VimuthWickramasinghe/robotikka/Schematic.pdf

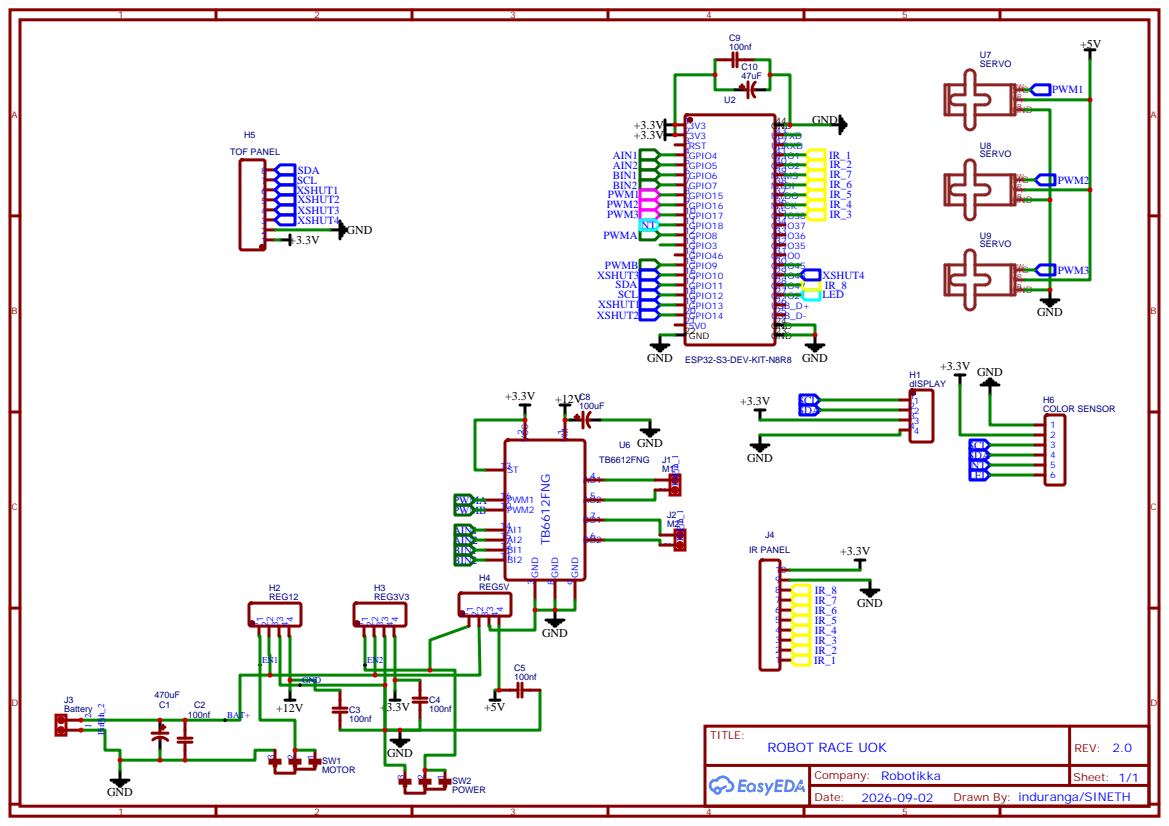
[picture p1: page 1]

Drawn By: induranga/SINETH
