VimuthWickramasinghe/robotikka/LineSensor.cpp

#include "LineSensor.h"
#include "MotorDriver.h"
#include "IRDisplay.h"
#include "globals.h"

// ==============================================================================
// GLOBAL PID VARIABLES
// ==============================================================================

// Global PID configuration (tuned defaults)
PIDConfig g_pidConfig = {
  45.0f,   // Kp
  0.0f,    // Ki
  25.0f,   // Kd
  50,     // baseSpeed (0 - 255)
  50,     // maxSpeed (0 - 255)
  -100,    // minSpeed (-255 to 255, allows reverse pivot on sharp curves)
  50.0f,   // maxIntegral (anti-windup clamp)
  2000     // threshold (12-bit ADC threshold: 0 - 4095)
};

PIDConfig &pidConfig = g_pidConfig;

// Dedicated PID configuration for dashed / dotted lines
// Uses gentle Kp/Kd and a controlled base speed to avoid abrupt turning during gap entries/exits
PIDConfig g_dashPidConfig = {
  35.0f,   // Kp: lower proportional gain for smoother gap transitions
  0.0f,    // Ki: zero integral to prevent windup during line loss
  20.0f,   // Kd: damping
  45,      // baseSpeed: moderate speed for stable dash tracking
  50,      // maxSpeed
  0,       // minSpeed: keep wheels moving forward (no aggressive pivot in dashes)
  30.0f,   // maxIntegral
  2000     // threshold (fallback threshold)
};

// Global runtime tracking variables
float g_lineLastError = 0.0f;
float g_lineIntegral = 0.0f;
LineSensorState g_lastLineState = {};

// Internal static tracking variables
static float s_lastValidPosition = 0.0f;
static unsigned long s_lineLostTime = 0;
static unsigned long s_lastMicros = 0;

// ==============================================================================
// FUNCTIONS
// ==============================================================================

void resetLinePID() {
  g_lineLastError = 0.0f;
  g_lineIntegral = 0.0f;
  s_lastValidPosition = 0.0f;
  s_lineLostTime = 0;
  s_lastMicros = 0;
}

void initLineSensors() {
  // The line-following PID reads only GPIO2 through GPIO6.
  analogReadResolution(12);
  for (int i = 0; i < LINE_SENSOR_COUNT; i++) {
    pinMode(IR_PINS[i], INPUT);
  }
  resetLinePID();
}

void calibrateLineSensors() {
  if (hTaskCalibration != NULL) {
    g_runMode = IR_CALIBRATE;
    vTaskResume(hTaskCalibration);
  }
}

LineSensorState readLineSensors() {
  LineSensorState state;
  state.activeCount = 0;
  float weightedSum = 0.0f;
  float totalWeight = 0.0f;

  // Sensor array weights from left to right, GPIO2 through GPIO6.
  const float weights[LINE_SENSOR_COUNT] = {-2.0f, -1.0f, 0.0f, 1.0f, 2.0f};

  for (int i = 0; i < LINE_SENSOR_COUNT; i++) {
    state.raw[i] = analogRead(IR_PINS[i]);
    uint16_t thresh = (g_sensorThresholds[i] > 0) ? g_sensorThresholds[i] : g_pidConfig.threshold;
    state.isBlack[i] = (state.raw[i] > thresh);
    if (state.isBlack[i]) {
      state.activeCount++;
      weightedSum += weights[i];
      totalWeight += 1.0f;
    }
  }

  if (state.activeCount > 0) {
    state.lineFound = true;
    state.isDottedGap = false;
    state.position = weightedSum / totalWeight;
    s_lastValidPosition = state.position;
    s_lineLostTime = 0;
  } else {
    // No sensor currently detects the line
    state.lineFound = false;
    if (s_lineLostTime == 0) {
      s_lineLostTime = millis();
    }

    // Trajectory hold across dotted gaps (< 350 ms)
    if (millis() - s_lineLostTime < 350) {
      state.isDottedGap = true;
      state.position = s_lastValidPosition;
    } else {
      state.isDottedGap = false;
      // Hard off-track: maintain sign of last seen position to steer back towards line
      state.position = (s_lastValidPosition >= 0.0f) ? 2.0f : -2.0f;
    }
  }

  g_lastLineState = state;
  return state;
}

void follow_line() {
  LineSensorState state = readLineSensors();
  queueIRDisplayUpdate(state, false);

  unsigned long nowMicros = micros();
  float dt = (s_lastMicros == 0) ? 0.002f : (float)(nowMicros - s_lastMicros) / 1000000.0f;
  if (dt <= 0.0f || dt > 0.05f) {
    dt = 0.002f; // Fallback to nominal 2 ms (500 Hz) if jitter or first call
  }
  s_lastMicros = nowMicros;

  float lineError = state.position;

  // Proportional term
  float P = g_pidConfig.Kp * lineError;

  // Integral term with anti-windup clamp
  g_lineIntegral += (lineError * dt);
  g_lineIntegral = constrain(g_lineIntegral, -g_pidConfig.maxIntegral, g_pidConfig.maxIntegral);
  float I = g_pidConfig.Ki * g_lineIntegral;

  // Derivative term (rate of change of error)
  float D = g_pidConfig.Kd * ((lineError - g_lineLastError) / dt);
  g_lineLastError = lineError;

  // Total steering correction
  float correction = P + I + D;

  // Differential drive motor speeds:
  // Motor A = Left Motor, Motor B = Right Motor
  // If lineError > 0 (line is to the right): Left speeds up, Right slows down -> turns Right
  int leftMotorSpeed  = g_pidConfig.baseSpeed + (int)correction;
  int rightMotorSpeed = g_pidConfig.baseSpeed - (int)correction;

  // If currently traversing a dotted gap, maintain straight forward momentum
  if (state.isDottedGap) {
    leftMotorSpeed  = g_pidConfig.baseSpeed;
    rightMotorSpeed = g_pidConfig.baseSpeed;
  }

  // Constrain outputs to configured limits
  leftMotorSpeed  = constrain(leftMotorSpeed, g_pidConfig.minSpeed, g_pidConfig.maxSpeed);
  rightMotorSpeed = constrain(rightMotorSpeed, g_pidConfig.minSpeed, g_pidConfig.maxSpeed);

  setMotorASpeed(rightMotorSpeed);
  setMotorBSpeed(leftMotorSpeed);
}

void follow_dash_line() {
  LineSensorState state = readLineSensors();
  queueIRDisplayUpdate(state, false);

  unsigned long nowMicros = micros();
  float dt = (s_lastMicros == 0) ? 0.002f : (float)(nowMicros - s_lastMicros) / 1000000.0f;
  if (dt <= 0.0f || dt > 0.05f) {
    dt = 0.002f; // Fallback to nominal 2 ms (500 Hz)
  }
  s_lastMicros = nowMicros;

  float lineError = state.position;

  // When sensors see the dash segment, apply dash PID steering
  if (state.lineFound) {
    float P = g_dashPidConfig.Kp * lineError;

    // Integral term with anti-windup clamp
    g_lineIntegral += (lineError * dt);
    g_lineIntegral = constrain(g_lineIntegral, -g_dashPidConfig.maxIntegral, g_dashPidConfig.maxIntegral);
    float I = g_dashPidConfig.Ki * g_lineIntegral;

    // Derivative term
    float D = g_dashPidConfig.Kd * ((lineError - g_lineLastError) / dt);
    g_lineLastError = lineError;

    float correction = P + I + D;

    int leftMotorSpeed  = g_dashPidConfig.baseSpeed + (int)correction;
    int rightMotorSpeed = g_dashPidConfig.baseSpeed - (int)correction;

    leftMotorSpeed  = constrain(leftMotorSpeed, g_dashPidConfig.minSpeed, g_dashPidConfig.maxSpeed);
    rightMotorSpeed = constrain(rightMotorSpeed, g_dashPidConfig.minSpeed, g_dashPidConfig.maxSpeed);

    setMotorASpeed(rightMotorSpeed);
    setMotorBSpeed(leftMotorSpeed);
  } else {
    // Over a gap between dashes:
    // Freeze integral to prevent error accumulation across gaps
    g_lineLastError = 0.0f;

    if (state.isDottedGap) {
      // Hold forward trajectory smoothly through the gap without oscillating
      setMotorASpeed(g_dashPidConfig.baseSpeed);
      setMotorBSpeed(g_dashPidConfig.baseSpeed);
    } else {
      // Line lost longer than dotted gap threshold: slow pivot towards last seen direction
      int pivotSpeed = g_dashPidConfig.baseSpeed / 2;
      if (s_lastValidPosition >= 0.0f) {
        // Line was on the right: turn right
        setMotorASpeed(-pivotSpeed);
        setMotorBSpeed(pivotSpeed);
      } else {
        // Line was on the left: turn left
        setMotorASpeed(pivotSpeed);
        setMotorBSpeed(-pivotSpeed);
      }
    }
  }
}

void printLineSensorValues() {
  LineSensorState state = readLineSensors();
  for (int i = 0; i < LINE_SENSOR_COUNT; i++) {
    Serial.print(state.raw[i]);
    if (i < LINE_SENSOR_COUNT - 1) {
      Serial.print(" ");
    }
  }
  Serial.printf(" | Pos: %+.2f | Count: %d | Found: %s\n",
                state.position, state.activeCount, state.lineFound ? "YES" : "NO");
}
