VimuthWickramasinghe/robotikka/button_task.cpp

#include "globals.h"
#include "Config.h"
#include <Arduino.h>
#include <WiFi.h>

// Task handle references for control
extern TaskHandle_t hTaskTelemetryOTA;
extern TaskHandle_t hTaskRobotControl;
extern TaskHandle_t hTaskCalibration;

// ============================================================
// BUTTON TASK — 8-Color Command Selector
// ============================================================
//
// How it works:
//   1. On boot, buttonTaskInit() attaches an ISR to the BOOT
//      button (GPIO 0) and creates the task in SUSPENDED state.
//   2. When the user presses the BOOT button at any time (even
//      during maze run), the ISR resumes the task.
//   3. The task cycles through 8 colors on the onboard RGB LED.
//      Each color = one command.
//   4. User presses button during the desired color → LED blinks
//      that color for ~3 seconds.
//   5. User presses button again within 3 s → command confirmed,
//      corresponding flag is set, task suspends itself.
//   6. If no press within 3 s → selection cancelled, resumes
//      cycling through all 8 colors.
//
// ============================================================

// --- State Machine ---
enum ButtonState : uint8_t {
    BTN_IDLE,
    BTN_COLOR_SELECT,
    BTN_CONFIRM_BLINK
};

// --- 8 Colors (R, G, B) ---
#define NUM_COLORS 8

struct Color {
    uint8_t r, g, b;
    const char *name;
};

static const Color COLORS[NUM_COLORS] = {
    {255,   0,   0, "linefollow"},
    {  0, 255,   0, "OTA mode"},
    {  0,   0, 255, "IR calibrate"},
    {255, 255,   0, "command4"},
    {255,   0, 255, "command5"},
    {  0, 255, 255, "command6"},
    {128,   0, 255, "competition"},
    {255, 128,   0, "command8"}
};

// --- ISR flag + first-edge timestamp (debounce reference) ---
static volatile bool s_isrButtonPress = false;
static volatile TickType_t s_lastPressTicks = 0;
// Timestamp of the press that entered the current test mode (set in
// setRunMode); any ISR edge raised within 300 ms of it is bounce residue
static volatile TickType_t s_consumeAnchorTicks = 0;

// Exposed for other tasks (e.g. TaskRobotControl in COLOR_DETECT /
// MOTOR_TEST modes) to poll & consume BOOT presses. Always clears the
// pending flag so no stale presses linger; a press is only honored if
// its edge came well after the press that started the mode (bounce filter).
bool consumeButtonPress() {
    bool pressed = s_isrButtonPress;
    s_isrButtonPress = false;
    if (!pressed) return false;

    if (s_consumeAnchorTicks != 0 &&
        s_lastPressTicks - s_consumeAnchorTicks < pdMS_TO_TICKS(300)) {
        return false;   // bounce residue from the mode-entry press
    }
    return true;
}
// --- Task handle (created suspended, resumed by ISR) ---
static TaskHandle_t s_buttonTaskHandle = NULL;

// --- ISR: set flag + timestamp and resume button task ---
static void IRAM_ATTR onBootButtonISR() {
    s_isrButtonPress = true;
    s_lastPressTicks = xTaskGetTickCountFromISR();

    if (s_buttonTaskHandle != NULL) {
        if (xTaskResumeFromISR(s_buttonTaskHandle) == pdTRUE) {
            portYIELD_FROM_ISR();
        }
    }
}

// --- Helper: turn RGB LED off ---
static void rgbOff() {
    neopixelWrite(RGB_LED_PIN, 0, 0, 0);
}

// --- Helper: set RGB LED to a color ---
static void rgbSet(uint8_t r, uint8_t g, uint8_t b) {
    neopixelWrite(RGB_LED_PIN, r, g, b);
}

// --- Helper: map color index to RunMode ---
static void setRunMode(uint8_t idx) {
    switch (idx) {
        case 0: // linefollow
            g_runMode = LINE_FOLLOW;
            WiFi.mode(WIFI_OFF); // Disable WiFi for ADC2 unlock
            if (hTaskRobotControl != NULL) vTaskResume(hTaskRobotControl);
            if (hTaskTelemetryOTA != NULL) vTaskResume(hTaskTelemetryOTA);
            break;
        case 1: // OTA mode
            g_runMode = OTA_MODE;
            if (hTaskRobotControl != NULL) vTaskSuspend(hTaskRobotControl);
            if (hTaskTelemetryOTA != NULL) vTaskResume(hTaskTelemetryOTA);
            break;
        case 2: // IR calibrate
            g_runMode = IR_CALIBRATE;
            WiFi.mode(WIFI_OFF); // Disable WiFi for ADC2 unlock
            if (hTaskCalibration != NULL) vTaskResume(hTaskCalibration);
            if (hTaskRobotControl != NULL) vTaskSuspend(hTaskRobotControl);
            if (hTaskTelemetryOTA != NULL) vTaskResume(hTaskTelemetryOTA);
            break;
        case 3: // command4 — live TCS34725 color detect (runs in TaskRobotControl)
            g_runMode = COLOR_DETECT;
            s_consumeAnchorTicks = xTaskGetTickCount();  // debounce reference
            WiFi.mode(WIFI_OFF); // keep wireless OFF for competition compliance
            if (hTaskRobotControl != NULL) vTaskResume(hTaskRobotControl);
            if (hTaskTelemetryOTA != NULL) vTaskSuspend(hTaskTelemetryOTA);
            break;
        case 4: // command5 — motor PWM sweep test (runs in TaskRobotControl)
            g_runMode = MOTOR_TEST;
            s_consumeAnchorTicks = xTaskGetTickCount();  // debounce reference
            WiFi.mode(WIFI_OFF);
            if (hTaskRobotControl != NULL) vTaskResume(hTaskRobotControl);
            if (hTaskTelemetryOTA != NULL) vTaskSuspend(hTaskTelemetryOTA);
            break;
        case 5: // command6 — servo 30-90deg swing test (runs in TaskRobotControl)
            g_runMode = SERVO_TEST;
            s_consumeAnchorTicks = xTaskGetTickCount();  // debounce reference
            WiFi.mode(WIFI_OFF);
            if (hTaskRobotControl != NULL) vTaskResume(hTaskRobotControl);
            if (hTaskTelemetryOTA != NULL) vTaskSuspend(hTaskTelemetryOTA);
            break;
        case 6: // command7 — WAYA 2.0 full autonomous competition run
            g_runMode = COMPETITION_RUN;
            s_consumeAnchorTicks = xTaskGetTickCount();  // debounce reference
            WiFi.mode(WIFI_OFF); // keep wireless OFF for competition compliance
            if (hTaskRobotControl != NULL) vTaskResume(hTaskRobotControl);
            if (hTaskTelemetryOTA != NULL) vTaskSuspend(hTaskTelemetryOTA);
            break;
        case 7: // command8 — TOF continuous distance stream (runs in TaskRobotControl)
            g_runMode = TOF_STREAM;
            s_consumeAnchorTicks = xTaskGetTickCount();  // debounce reference
            WiFi.mode(WIFI_OFF);
            if (hTaskRobotControl != NULL) vTaskResume(hTaskRobotControl);
            if (hTaskTelemetryOTA != NULL) vTaskSuspend(hTaskTelemetryOTA);
            break;
    }
}

// ============================================================
// TASK: buttonLogicTask
// ============================================================

void buttonLogicTask(void *pvParameters) {
    (void)pvParameters;

    Serial.println("[DEBUG] buttonLogicTask created, priority 4, stack 4096");

    // Suspend immediately until ISR-resumed by first button press
    vTaskSuspend(NULL);

    ButtonState state       = BTN_IDLE;
    uint8_t     colorIdx    = 0;
    uint8_t     tickCount   = 0;
    uint32_t    lastColorMs = 0;

    // Show "system alive" pulse at startup: quick white flash
    rgbSet(20, 20, 20);
    vTaskDelay(pdMS_TO_TICKS(100));
    rgbOff();

    while (true) {
        // Poll the ISR flag (safe to read volatile from task)
        bool pressed = s_isrButtonPress;
        if (pressed && (g_runMode == COLOR_DETECT || g_runMode == MOTOR_TEST ||
                        g_runMode == SERVO_TEST || g_runMode == TOF_STREAM || g_runMode == COMPETITION_RUN)) {
            // Boot press during a control-task test loop belongs to
            // TaskRobotControl's exit check — leave the flag untouched
            // for it to consume
            pressed = false;
        } else if (pressed) {
            s_isrButtonPress = false;

            // Simple debounce: ignore if pressed < 250 ms ago
            static uint32_t lastPressMs = 0;
            uint32_t now = millis();
            if (now - lastPressMs < 250) {
                pressed = false;
            } else {
                lastPressMs = now;
            }
        }

        switch (state) {

            // ------------------------------------------------
            // IDLE — task is running but LED is off
            // Button press starts color cycling
            // ------------------------------------------------
            case BTN_IDLE:
                if (pressed) {
                    state       = BTN_COLOR_SELECT;
                    colorIdx    = 0;
                    tickCount   = 0;
                    lastColorMs = millis();
                    rgbSet(COLORS[colorIdx].r, COLORS[colorIdx].g, COLORS[colorIdx].b);
                    Serial.println("[BTN] Color select started");
                }
                break;

            // ------------------------------------------------
            // COLOR_SELECT — cycle through 8 colors
            // Button press selects current color → confirm
            // ------------------------------------------------
            case BTN_COLOR_SELECT:
                // Advance color every 500 ms
                if (millis() - lastColorMs >= 500) {
                    lastColorMs = millis();
                    colorIdx = (colorIdx + 1) % NUM_COLORS;
                    rgbSet(COLORS[colorIdx].r, COLORS[colorIdx].g, COLORS[colorIdx].b);
                }

                if (pressed) {
                    state     = BTN_CONFIRM_BLINK;
                    tickCount = 0;
                    Serial.printf("[BTN] Selected: %s — confirm?\n", COLORS[colorIdx].name);
                }
                break;

            // ------------------------------------------------
            // CONFIRM_BLINK — blink chosen color for 3 s
            // Button press → confirmed (set flag, go IDLE)
            // Timeout     → cancelled (resume COLOR_SELECT)
            // ------------------------------------------------
            case BTN_CONFIRM_BLINK:
                // Blink: ON for 200 ms, then OFF next tick (total ~400 ms cycle)
                tickCount++;
                if (tickCount % 2 == 1) {
                    rgbSet(COLORS[colorIdx].r, COLORS[colorIdx].g, COLORS[colorIdx].b);
                } else {
                    rgbOff();
                }

                if (pressed) {
                    // Confirmed
                    setRunMode(colorIdx);
                    rgbOff();
                    state = BTN_IDLE;
                    Serial.printf("[BTN] CONFIRMED: %s\n", COLORS[colorIdx].name);
                    
                    // Suspend task so it consumes 0 CPU until next button press
                    vTaskSuspend(NULL);
                } else if (tickCount >= 15) {
                    // Timeout (~3 s): no confirmation
                    rgbOff();
                    state       = BTN_COLOR_SELECT;
                    tickCount   = 0;
                    lastColorMs = millis();
                    rgbSet(COLORS[colorIdx].r, COLORS[colorIdx].g, COLORS[colorIdx].b);
                    Serial.println("[BTN] Confirm timeout, resuming cycle");
                }
                break;
        }

        vTaskDelay(pdMS_TO_TICKS(200));  // 5 Hz
    }
}

// ============================================================
// buttonTaskInit — call from setup() AFTER createTasks()
// ============================================================
//
// 1. Configure BOOT button GPIO with internal pull-up
// 2. Attach falling-edge ISR
// 3. Create the button task in SUSPENDED state
//
// The task only runs when the ISR calls xTaskResumeFromISR().
// This means the button task uses ZERO CPU until the user
// actually presses the boot button.
// ============================================================

void buttonTaskInit() {
    // Configure boot button pin
    pinMode(BOOT_BUTTON_PIN, INPUT_PULLUP);

    // Create the task FIRST (handle must be valid) — task calls vTaskSuspend(NULL)
    // as its very first action, so it can't race ahead
    BaseType_t result = xTaskCreatePinnedToCore(
        buttonLogicTask,
        "buttonLogic",
        4096,
        NULL,
        4,              // priority 4
        &s_buttonTaskHandle,
        0               // Core 0
    );

    if (result != pdPASS || s_buttonTaskHandle == NULL) {
        Serial.println("[ERR] Failed to create buttonLogicTask!");
        return;
    }

    // Only attach the ISR AFTER the task handle is valid, so an early press
    // can never resume a NULL handle and get silently lost
    attachInterrupt(digitalPinToInterrupt(BOOT_BUTTON_PIN),
                    onBootButtonISR, FALLING);

    Serial.println("[BTN] Boot button ISR attached, task suspended (idle until press)");
    Serial.flush();
}
