VimuthWickramasinghe/robotikka/(commit log)

2026-10-07 Refactor robot control architecture and add modular components for motor, line sensor, and PID control
2026-10-07 Add IR sensor debugging features and update command interface
    - Implement functions to enable/disable continuous IR sensor printing.
    - Add detailed printing of IR sensor readings, including raw values and line status.
    - Update README with new commands for IR sensor output.
    - Modify servo command help to include IR sensor commands.
2026-10-08 Fix button task to restore suspended state and correct PIN naming
    [Config.h, button_task.cpp, globals.cpp, globals.h, robotikka.ino]
2026-10-22 Add color sensor, motor, TOF stream and servo swing test modes with button menu
    - Deterministic task suspension (MODE_IDLE default, self-suspend on start)
    - ColorSensor: TCS34725 on shared I2C (11/12), illumination LED GPIO21, majority-wins RGB LED
    - MotorDriver: TB6612 analogWrite 20kHz on Config.h pins (PWMA=38, PWMB=9)
    - TOFSensors: 5x VL53L0X continuous mode, unique addresses (FC=0x30, R60=0x31, FL=0x32, L60=0x33, FR=0x34), XSHUT boot assignment
    - ServoControl: ESP32Servo swing test on PWM1/PWM2 (30/90deg)
    - button_task: command modes 3-7, bounce filter, press gating per mode
    - Removed LinePID placeholders (pre-PID implementation)
2026-10-22 feat: Implement PID-based line following control
    - Added PID configuration structure and global variables for line following.
    - Implemented PID control logic in follow_line() function to adjust motor speeds based on line sensor readings.
    - Enhanced readLineSensors() to calculate weighted position and handle dotted gaps.
    - Introduced resetLinePID() to reset PID tracking variables.
    - Updated printLineSensorValues() for improved output formatting.
    - Modified initLineSensors() to include ADC resolution setup.
    - Updated LineSensor.h with new PIDConfig structure and function declarations.
    - Adjusted robotikka.ino to utilize follow_line() in the control loop.
    - Changed Wi-Fi credentials for OTA upl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
2026-10-23 feat: Implement IR Calibration and Display Features
    - Added CalibrationWeb for managing IR sensor calibration via a web interface.
    - Introduced TaskCalibration for handling calibration tasks in FreeRTOS.
    - Enhanced globals to include calibration-related variables and flags.
    - Updated ServoControl to reflect changes in IR sensor commands.
    - Integrated IRDisplay for real-time display of sensor data during calibration.
    - Modified button_task to manage task states during calibration mode.
    - Created HTML/CSS/JS interface for calibration with live updates on sensor readings.
    - Implemented PID tuning parameters in the calibration web interface.
2026-10-23 feat: Add dedicated PID configuration and follow_dash_line function for dashed line tracking
2026-10-23 Add wall-follow PD test, SH1106 display API, calibration web server and IR display; flip upside-down TOF panel mapping
2026-10-24 Refactor servo control for arm and gripper functionality; add dedicated methods for initialization, movement, and object handling
2026-10-24 Add competition task management and state tracking; implement competition stages and emergency stop functionality
